lk888l/wheeled-legged_Robot-WL1/car_firmware/README_en.md

# WL1 Car Firmware

[中文](README.md) | [English](README_en.md) | [Back to project README](../README_en.md)

`car_firmware` is the vehicle-side firmware for the WL1 wheeled-legged robot. It
targets the STM32F411CEU6. The firmware reads the MPU6050 and the left and right
wheel encoders, runs cascaded PID control, drives two DC motors through a TB6612
and two leg servos, and receives remote commands over a Bluetooth UART, with optional nRF24L01+ support.

The current runtime path uses STM32 HAL, FreeRTOS, and C++23:

- `save` persists all motion tunings, the shared wheel-PWM dead zone, the angle Kp mode, and the adaptive leg-height switch to internal Flash; automatic Kp uses a tunable 61.5 mm reference with linear height compensation (see the [save protocol](docs/commands.md#flash-参数保存));
- A 10 ms attitude loop that calculates left and right wheel PWM;
- A 50 ms loop for speed, steering, roll, and leg-height control;
- ZX-D30 BLE UART at 9600 8N1 by default; nRF24L01+ is optional and disabled by default;
- USART1 DMA transmission and reception for online status monitoring and control-parameter updates;
- Runtime center-of-gravity pitch baseline tuning with `anglebias` over the car UART or
  BLE, with compensation based on the mean of both clamped leg targets
  (see the [command reference](docs/commands.md#控制命令));
- `rollbias` calibrates the roll midpoint used by adaptive leg height over the car UART/BLE
  or optional nRF commands; `save` retains the calibration across power cycles;
- Fixed-capacity ETL containers for command queues and UART buffers;
- Explicit, ordered hardware initialization calls in `main.cpp`, with a lightweight
  report that records every result without skipping later modules;
- A fail-safe gate that keeps wheel PWM at zero and does not create balancing
  tasks if required control hardware initialization fails, while preserving available
  command channels.

Further reading:

- [Software architecture](docs/architecture.md): startup flow, tasks, control loops, and concurrency model;
- [Command reference](docs/commands.md): serial/wireless commands, default parameters, and tuning sequence;
- [Debugging and troubleshooting](docs/troubleshooting.md): power-on checks, common faults, and CubeMX regeneration checks.

> [!WARNING]
> Balancing is enabled after the required control hardware and application
> tasks start successfully. This software gate does not replace physical safety:
> raise the wheels, disconnect motor power, or use a current-limited supply during
> initial flashing and tuning.

The car now provides PA0 onboard KEY click, double-click, and long-press events.
`ButtonTask` polls every 5 ms at priority 1 with a static 128-word stack and a bounded
event queue. All five application tasks derive from `AppTask`; the composition root
injects their dependencies. The existing 10/50 ms control periods and priorities remain.
Use the `button` command to inspect counts, dropped events, and the maximum sampling gap.
See [button integration](docs/button-a0.md) for timing semantics and validation (Chinese).

The Bluetooth build defaults to ZX-D30 on USART1 at 9600 8N1 and disables nRF initialization.
UART/radio availability and command-task creation do not gate balancing. Motion commands
expire after 500 ms: speed, turn and roll return to zero while balancing and leg-height
control continue. WeChat requires a BLE UART module; classic HC-05/JDY-31 SPP cannot
connect directly. See [Bluetooth UART setup and validation](docs/bluetooth-uart.md).

## Quick Start

### 1. Prepare the Tools

- CMake 3.28 or later;
- Ninja, Make, or another CMake-supported build tool;
- Arm GNU Toolchain with the `arm-none-eabi-` command prefix;
- OpenOCD and an ST-Link for flashing and debugging;
- STM32CubeMX (optional), required only when changing `.ioc` peripheral settings.

Verify that the tools are available in `PATH`:

```sh
cmake --version
arm-none-eabi-gcc --version
openocd --version
```

### 2. Build

Run the following commands in the `car_firmware` directory:

```sh
cmake -S . -B build/Debug -G Ninja -DCMAKE_BUILD_TYPE=Debug
cmake --build build/Debug --parallel
```

For an optimized build intended to run on the robot:

```sh
cmake -S . -B build/Release -G Ninja -DCMAKE_BUILD_TYPE=Release
cmake --build build/Release --parallel
```

Run the host regression tests for initialization, tasks, buttons, commands, and PID without a board:

```sh
cmake -S tests -B build/host-tests -G Ninja
cmake --build build/host-tests --parallel
ctest --test-dir build/host-tests --output-on-failure
```

If Ninja is unavailable, replace `-G Ninja` with an available generator, such as
`-G "MinGW Makefiles"` on Windows. Use a new build directory when changing
generators.

Build outputs are placed in the selected build directory:

- `WL1_F411CEU6_update.hex/.bin`: application update, preserving saved parameters;
- `WL1_F411CEU6_factory.hex/.bin`: first installation or factory reset, including a default parameter record;
- `WL1_F411CEU6.elf`: application debugging/flashing, without parameter records;
- `WL1_F411CEU6.hex/.bin`: compatibility names with the same contents as update;
- `WL1_F411CEU6.map`: linker map and memory analysis.

Build configurations:

| `CMAKE_BUILD_TYPE` | Compiler options | Purpose |
| --- | --- | --- |
| `Debug` or unspecified | `-Og -g` | Debugging, stepping, and variable inspection |
| `Release` | `-O3 -fno-fast-math` | Normal operation; preserves VQF NaN initialization semantics |
| `RelWithDebInfo` | `-O3 -fno-fast-math -g` | Optimized execution with debug information |
| `MinSizeRel` | `-Os` | Minimize image size |

The project always uses the Cortex-M4F hard-float ABI (`fpv4-sp-d16`), C11, and
C++23.

### 3. Flash with ST-Link

Connect SWDIO, SWCLK, GND, and the target-board reference voltage. For blank chips,
chips previously running other firmware, or a deliberate factory reset, run:

```sh
cmake --build build/Release --target flash_factory
# Later updates that retain saved tuning:
cmake --build build/Release --target flash_update
```

Factory erases sectors 0–7 and writes compiled defaults. Update erases only
sectors 0–6 and preserves the entire parameter sector 7. Both targets verify
the image and reset the device into normal operation.

If the controller supply has been independently verified while a particular
probe still reports a false low Vref, use the tested 100 kHz compatibility path:

```sh
openocd -f STlink_hla.cfg \
  -f build/Release/flash_factory.cfg
# For later updates use build/Release/flash_update.cfg.
```

Alternatively configure `WL1_OPENOCD_CONFIG` with the absolute path to
`STlink_hla.cfg` so the CMake flash targets use that probe backend.
Keep each generated flash script beside its matching HEX image.
An image does not encode erase policy: factory programming must erase all of
sector 7, including old records after the default record. See
[installation and parameter retention](docs/flash-images.md).

Full-image write and verification were tested at 1800 kHz; reset returns to the
100 kHz debugging speed. The deprecated HLA backend is only a compatibility
fallback for a confirmed measurement fault; use `STlink.cfg` for normal probes.

USART1 now prints one `[init][ OK ]` or `[init][FAIL]` line per module and ends
with an application summary. Only `state=ready control=on` means balancing and
motor output are allowed. A failed module is reported immediately, but the
remaining initialization steps still run.

## Startup Safety and PC13 Heartbeat

After the scheduler starts, `AppBootstrap` calls `CPP_Main()`. The entry point in
`Component/UserApp/main.cpp` explicitly initializes command UART, MPU6050, left
encoder, right encoder, wheel-motor PWM, left servo, and right servo in that
order. The optional nRF24L01+ is initialized last only when `WL1_ENABLE_NRF24=ON`
and is skipped by default. Each call records and logs its result, followed by a
3 ms delay; later modules are still attempted after a failure.

`InitializationReport::all_succeeded(bsp::kRequiredHardwareMask)` requires a valid
report and successful attempts for every required module. A missing required
module also fails this gate. A failed gate prevents `ServoControl` and
`MotionControl` from being created and forces safe
outputs. `Heartbeat` remains independent; `CommandService` remains available
when either USART1 or nRF initialized successfully.

PC13 is treated as active-low:

| State | LED pattern | Meaning |
| --- | --- | --- |
| `booting` | 100 ms on / 100 ms off | Initialization in progress |
| `ready` | 80 ms on / 920 ms off | Control enabled |
| `init-failed` | Two short flashes, then pause | Hardware failure; safe mode |
| `task-failed` | Three short flashes, then pause | Application task creation failed |
| `runtime-fault` | 80 ms on / 80 ms off | Runtime IMU failure; outputs stopped |

Without a serial adapter, inspect `g_app_system_state`,
`g_app_hardware_attempted_mask`, `g_app_hardware_failed_mask`, `g_app_task_failed_mask`, and
`g_app_control_enabled` through ST-Link/GDB.

## First Power-On

Use the following sequence to narrow down faults safely:

1. Disconnect motor power or raise the wheels off the ground, and power only the logic circuitry and ST-Link;
2. Confirm that USART1 receives the startup log;
3. Run `showimu -y` and verify that the attitude values remain stable while the robot is stationary;
4. Run `showrpm -y`, turn each wheel by hand, and confirm that both encoders respond;
5. Power the servos and use `legheight 44.5` to check the direction and mechanical limits on both sides;
6. Connect the Bluetooth client, send a motion command with zero velocity, steering, and roll, then use `controlstate` to check the targets;
7. Finally, connect motor power and check the feedback direction using a current-limited power supply and a stand.

For detailed checks, see [Debugging and troubleshooting](docs/troubleshooting.md).

## Hardware Connections

See the [hardware files on the project homepage](../README_en.md#hardware-files)
for the PCB fabrication archive and schematic PDF.

### Core and Debug Interfaces

| Function | MCU pin | Parameters |
| --- | --- | --- |
| USART1 TX | PA15 | 9600 (configurable), 8-N-1, DMA2 Stream 7 |
| USART1 RX | PA10 | 9600 (configurable), 8-N-1, DMA2 Stream 5, receive-to-idle |
| SWDIO | PA13 | ST-Link |
| SWCLK | PA14 | ST-Link |
| Status LED | PC13 | Active-low; state-dependent heartbeat above |
| HSE | PH0/PH1 | 25 MHz |
| LSE | PC14/PC15 | 32.768 kHz |

PA15 is not the usual default USART1_TX pin. When connecting a serial adapter,
follow this table and `Core/Src/usart.c`.

### MPU6050

| Signal | MCU pin | Parameters |
| --- | --- | --- |
| SCL | PB6 | I2C1, 400 kHz |
| SDA | PB7 | I2C1, 400 kHz |
| Address | — | 7-bit `0x68` (the driver uses the left-shifted value `0xD0`) |

The current configuration uses a ±1000 °/s gyroscope range, a ±4 g accelerometer
range, and VQF for attitude fusion. DLPF=0 and SMPLRT_DIV=9 retain 800 Hz sensor
register updates; the host reads and advances VQF at 100 Hz (10 ms).
Ordinary `control off` keeps the estimator running with actuators disabled.
`control on` retains the learned bias and still requires the 500 ms startup gate.
Installation and exclusive maintenance can still pause sampling.

### Motors and Encoders

| Function | MCU pin | Peripheral |
| --- | --- | --- |
| Left-wheel PWM / TB6612 A | PA8 | TIM1_CH1, approximately 10 kHz |
| Right-wheel PWM / TB6612 B | PA9 | TIM1_CH2, approximately 10 kHz |
| AIN1 / AIN2 | PA6 / PA7 | Left-wheel direction |
| BIN1 / BIN2 | PB0 / PB1 | Right-wheel direction |
| Left encoder A / B | PA5 / PA1 | TIM2_CH1 / CH2 |
| Right encoder A / B | PB4 / PB5 | TIM3_CH1 / CH2 |

The current PID path inverts the TB6612 B-channel direction. Both PWM channels
share a runtime-adjustable minimum nonzero compare value. It defaults to zero, so
compensation is disabled until set with `deadzone <0..1000>` and persisted with `save`.
The final PWM command is limited to `-1000..1000`. A zero command uses a dedicated
safe branch, so the dead zone is not reapplied and the compare value remains zero.

### Leg Servos

| Function | MCU pin | Peripheral |
| --- | --- | --- |
| Left-leg servo | PA2 | TIM9_CH1 |
| Right-leg servo | PA3 | TIM9_CH2 |

TIM9 generates 100 Hz PWM. The software limits the target leg height to
`44.5..78.5 mm` and converts it to a servo angle using four-bar inverse
kinematics. Mechanical dimensions and coordinate-system definitions are in
`Component/UserApp/CtrlAlgorithm/LegKinematics.hpp`.

### nRF24L01+ (Optional, Disabled by Default)

This channel is enabled only when building with `-DWL1_ENABLE_NRF24=ON`.

| nRF signal | MCU pin | Description |
| --- | --- | --- |
| SCK | PB13 | SPI2_SCK |
| MISO | PB14 | SPI2_MISO |
| MOSI | PB15 | SPI2_MOSI |
| CSN | PA4 | Software-controlled chip select, active low |
| CE | PB12 | TX/RX mode control |
| IRQ | PA12 | Pull-up input, falling-edge EXTI; no floating pin when absent |
| VCC | 3.3 V | Do not connect to 5 V |
| GND | GND | Common ground with the MCU |

The SPI2 clock is approximately 6.25 Mbit/s, and both transmission and reception
use DMA. Place a decoupling capacitor near the nRF module's power pins. If the
wireless link behaves abnormally, first check the 3.3 V supply and common ground.

### Reserved OLED Interface

The driver in `Component/HardWare/OLED` is compiled, but the current application
does not initialize or refresh the OLED. CubeMX reserves these software-I²C pins:

| Signal | MCU pin |
| --- | --- |
| O_SCL | PB10 |
| O_SDA | PB3 |

## Remote-Control Command Protocol

Text commands are sent over the USART1 Bluetooth UART by default. Clients
should use `@<command>\n` framing, where `\n` represents an actual LF byte.
The motion-command body has the following format:

```text
R <turn_target> <velocity_target> <roll_degrees> <leg_height_mm>
```

Example:

```text
@R 0 0 0 61.5\n
```

The field order must remain steering, velocity, roll, and leg height. The
client's direction conventions must match the car's control coordinate system.
Command bodies are limited to 32 bytes, with support for BLE fragmentation.
See the [ZX-D30 Bluetooth documentation](docs/zx-d30.md) for wiring and BLE
configuration and the [command reference](docs/commands.md) for framing rules
and command limits.

### Optional nRF24L01+ Channel

When enabled, the car enters nRF receive mode only after initialization and
register readback verification succeed. A valid payload uses the same command
body, padded to 32 bytes with `0x00`. The RF settings are:

| Parameter | Current setting |
| --- | --- |
| Data rate | 2 Mbps |
| RF channel | 2 (2402 MHz) |
| Address width | 5 bytes |
| RX Pipe 0 / TX address | `11 52 01 31 41` |
| Payload width | 32 bytes |
| RF power | 0 dBm |
| CRC | 1 byte |
| Auto ACK | Enabled |
| Auto retry | 500 μs interval, up to 15 retries |

When using this channel, the sender's RF settings and `R` command format must
match the car. For all available commands and their limits, see the
[command reference](docs/commands.md).

## Software Structure

```text
car_firmware/
├── Component/
│   ├── Application/               # Initialization report, AppTask, runtime status
│   ├── Bsp/                       # Board facade, stable module IDs and names
│   ├── HardWare/
│   │   ├── IMU/                  # MPU6050 and VQF
│   │   ├── Motor/                # Encoders, TB6612, and servos
│   │   ├── OLED/                 # OLED driver, currently unused
│   │   └── Telecontrol/          # nRF24L01+ driver
│   ├── Module/
│   │   ├── Basic/                # TaskReactor and SafeQueue
│   │   └── include/etl/          # Embedded Template Library
│   ├── Peripheral/               # USART DMA wrapper
│   └── UserApp/
│       ├── CtrlAlgorithm/        # PID, LQR, and leg kinematics
│       ├── Tasks/                # Five AppTask-derived business tasks
│       ├── ControlState.hpp      # Coherent parameter and feedback snapshots
│       └── main.cpp              # Composition, initialization, and safety gates
├── Core/                         # STM32CubeMX-generated code
├── Drivers/                      # STM32 HAL / CMSIS
├── Middlewares/                  # FreeRTOS
├── CMakeLists.txt
├── CMakeLists_template.txt
├── STlink.cfg
├── STlink_hla.cfg                 # Low-speed fallback for confirmed false Vref
├── tests/                          # Host startup-semantics tests
└── WL1_F411CEU6.ioc
```

The C entry point is `Core/Src/main.c`. `MX_FREERTOS_Init()` creates only the
`AppBootstrap` task. After the scheduler starts, that task calls `CPP_Main()` to
construct board services, initialize every hardware step, and create eligible
application tasks, then deletes itself.

The structure draws on the composition entry point, module encapsulation, and
layering in [esp_idf_template](https://github.com/lk888l/esp32_idf/tree/main/esp_idf_template).
WL1 uses explicit per-module initialization calls in `main.cpp`, followed by a
single safety gate, and keeps available diagnostics after a failure. Hardware
initialization has no factory, function-pointer table, or observer callback.
Independent FreeRTOS task classes retain their constructor-injected dependencies
and static object lifetimes. See the [architecture guide](docs/architecture.md)
for the adaptation choices and steps for adding modules.

`MotionControlTask` runs the existing cascaded PID algorithm and is started only
after the safety gate passes. The LQR path remains available for experiments but
does not currently run. `MainControl.*` and OLED remain outside the runtime path.

## Development Guidelines

- Keep handwritten logic in `USER CODE` sections and synchronize generated GPIO changes with the `.ioc` file;
- `CMakeLists.txt` is marked as a template-generated file, so persistent changes should also be applied to `CMakeLists_template.txt`;
- Source globs use `CONFIGURE_DEPENDS` to discover new application task files;
- Derive business tasks from `AppTask`, inject dependencies, and exchange control data through `ControlState` snapshots;
- Assign new hardware a stable ID in `Bsp/HardwareModule.hpp`, then explicitly initialize it and record the result in `main.cpp`;
- Do not call regular FreeRTOS APIs from an ISR; use only the `...FromISR` variants;
- Interrupts that call FreeRTOS ISR APIs must have an NVIC numerical priority of 5 or greater;
- Avoid dynamic allocation, blocking I/O, and high-frequency UART output in control tasks;
- After changing wheel direction, encoder direction, or attitude signs, raise the wheels off the ground and verify the closed-loop feedback direction;
- When changing the remote-control command protocol, check the Bluetooth client, car firmware, and command documentation together;
- Before committing, complete at least Debug and Release builds and run `git diff --check`.
