lk888l/wheeled-legged_Robot-WL1/car_firmware/CMakeLists_template.txt

#${templateWarning}
set(CMAKE_SYSTEM_NAME Generic)
set(CMAKE_SYSTEM_VERSION 1)
${cmakeRequiredVersion}
# specify cross-compilers and tools
set(CMAKE_C_COMPILER arm-none-eabi-gcc)
set(CMAKE_CXX_COMPILER arm-none-eabi-g++)
set(CMAKE_ASM_COMPILER  arm-none-eabi-gcc)
set(CMAKE_AR arm-none-eabi-ar)
set(CMAKE_OBJCOPY arm-none-eabi-objcopy)
set(CMAKE_OBJDUMP arm-none-eabi-objdump)
set(SIZE arm-none-eabi-size)
set(CMAKE_TRY_COMPILE_TARGET_TYPE STATIC_LIBRARY)

# project settings
project(${projectName} C CXX ASM)
set(CMAKE_CXX_STANDARD 23)
set(CMAKE_C_STANDARD 11)

set(WL1_COMMAND_UART_BAUD "9600" CACHE STRING "Bluetooth/command UART baud rate")
if(NOT WL1_COMMAND_UART_BAUD MATCHES "^(9600|19200|38400|57600|115200|128000)$")
    message(FATAL_ERROR "Unsupported WL1_COMMAND_UART_BAUD")
endif()
option(WL1_ENABLE_NRF24 "Enable the optional SPI radio remote" OFF)
add_compile_definitions(WL1_COMMAND_UART_BAUD=${WL1_COMMAND_UART_BAUD}
    WL1_ENABLE_NRF24=$<BOOL:${WL1_ENABLE_NRF24}>)

#Uncomment for hardware floating point
add_compile_definitions(ARM_MATH_CM4;ARM_MATH_MATRIX_CHECK;ARM_MATH_ROUNDING)
add_compile_options(-mfloat-abi=hard -mfpu=fpv4-sp-d16)
add_link_options(-mfloat-abi=hard -mfpu=fpv4-sp-d16)

#Uncomment for software floating point
#add_compile_options(-mfloat-abi=soft)

add_compile_options(-mcpu=${mcpu} -mthumb -mthumb-interwork)
add_compile_options(-ffunction-sections -fdata-sections -fno-common -fmessage-length=0)

# uncomment to mitigate c++17 absolute addresses warnings
#set(CMAKE_CXX_FLAGS "$${CMAKE_CXX_FLAGS} -Wno-register")

# Enable assembler files preprocessing
add_compile_options($<$<COMPILE_LANGUAGE:ASM>:-x$<SEMICOLON>assembler-with-cpp>)

if ("$${CMAKE_BUILD_TYPE}" STREQUAL "Release")
    message(STATUS "Maximum optimization for speed")
    # VQF uses NaN filter-state sentinels; fast-math breaks its initialization.
    add_compile_options(-O3 -fno-fast-math)
elseif ("$${CMAKE_BUILD_TYPE}" STREQUAL "RelWithDebInfo")
    message(STATUS "Maximum optimization for speed, debug info included")
    add_compile_options(-O3 -fno-fast-math -g)
elseif ("$${CMAKE_BUILD_TYPE}" STREQUAL "MinSizeRel")
    message(STATUS "Maximum optimization for size")
    add_compile_options(-Os)
else ()
    message(STATUS "Minimal optimization, debug info included")
    add_compile_options(-Og -g)
endif ()

include_directories(${includes}
                    Component/Application Component/Bsp Component/UserApp Component/HardWare/OLED Component/HardWare/Motor Component/HardWare/IMU Component/Peripheral Component/Module/include
                    Component/Module/Basic Component/HardWare/Telecontrol
)

add_definitions(${defines})

file(GLOB_RECURSE SOURCES CONFIGURE_DEPENDS ${sources}
    "Component/Application/*.*" "Component/Bsp/*.*" "Component/UserApp/*.*" "Component/HardWare/OLED/*.*" "Component/HardWare/Motor/*.*" "Component/HardWare/IMU/*.*" "Component/HardWare/Telecontrol/*.*"
    "Component/Peripheral/*.*" "Component/Module/include/etl/*.*" "Component/Module/Basic/*.*"
    )

set(LINKER_SCRIPT $${CMAKE_SOURCE_DIR}/${linkerScript})

add_link_options(-Wl,-gc-sections,--print-memory-usage,-Map=$${PROJECT_BINARY_DIR}/$${PROJECT_NAME}.map)
add_link_options(-mcpu=${mcpu} -mthumb -mthumb-interwork)
add_link_options(-T $${LINKER_SCRIPT})

add_executable($${PROJECT_NAME}.elf $${SOURCES} $${LINKER_SCRIPT})

include(cmake/FirmwareImages.cmake)
