lk888l/wheeled-legged_Robot-WL1/hardware/BOM.xlsx

结构 |  | PCB
名称 | 数量 | 名称 | 数量
10*15*4轴承 | 2 | PCB主板 | 1
6*11*4轴承 | 4 | STM32F411CEU6最小系统 | 1
MG996R舵机180度 | 2 | MPU6050模块 | 1
12V600转/分钟 | 2 | TB6612模块 | 1
3000mah 12V锂电池+充电器 | 1 | 3V3降压模块 | 1
M3螺丝12mm | 4 | 5V降压模块 | 1
M4螺丝12mm | 8 | 蓝牙串口模块（ZX-D30） | 1
M2螺丝8mm | 2 | 1*20排母 | 2
M3螺丝5mm | 2 | ZH1.25*6直插座 | 2
50mm宽魔术贴 | 50mm | 1*3排针 | 1
 |  | 1*8排母 | 3
 |  | 1*4排母 | 3
 |  | zh1.5*6电机线(0.2m) | 2
 |  | 船型开关(10*15) | 1
 |  | DC母座(5.5*2.1) | 1
