lk888l/wheeled-legged_Robot-WL1/hardware/wheeled-legged_Robot-WL1-schematics.pdf

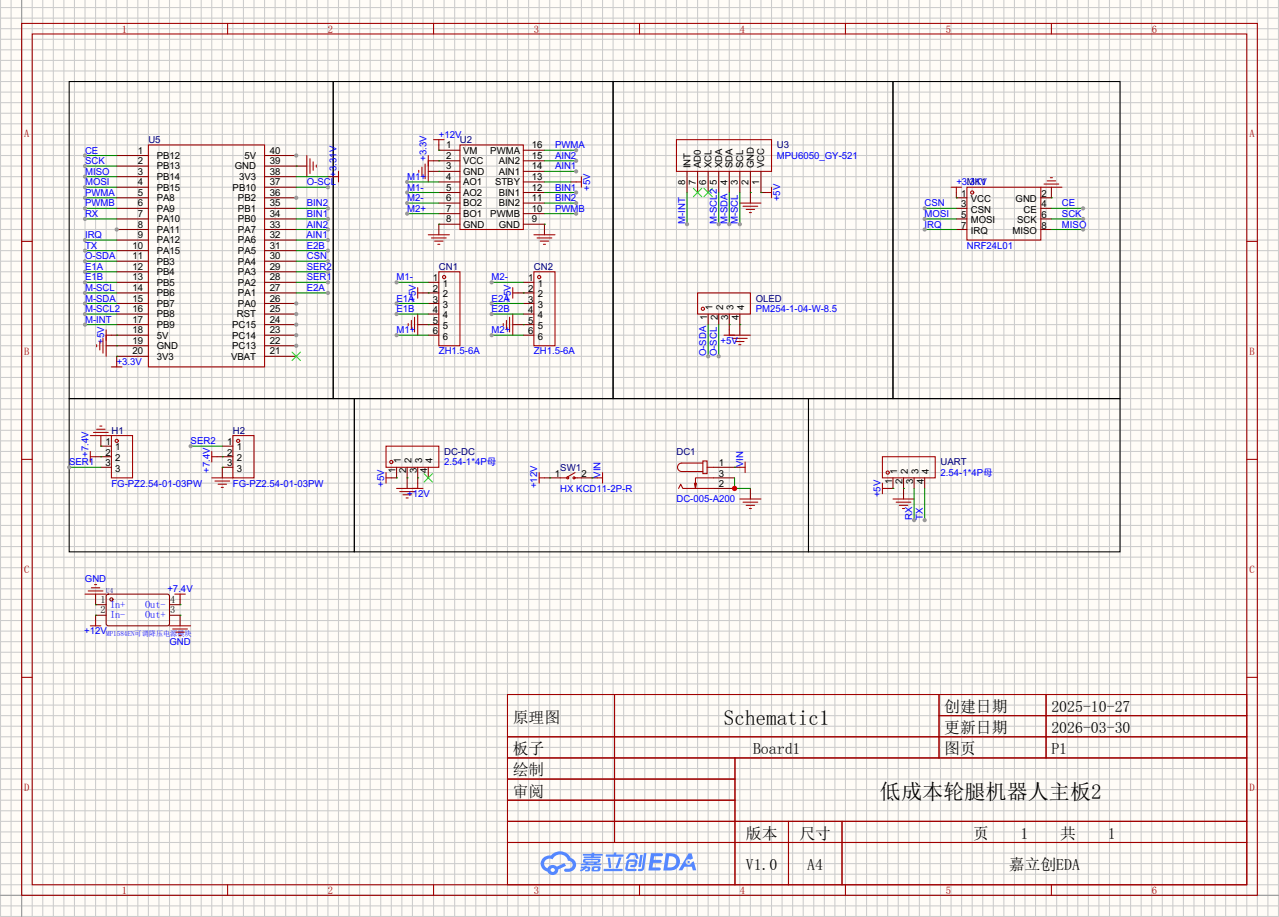
[picture p4: page 1]

SCK | | | PB13 2 | 3V3 | 38 GND 39 5V 40 | | | | | | | PWMB | | 10 BIN2 11 BIN1 12 STBY 13 AIN1 14 AIN2 15 PWMA 16 U2 | | AIN1
CE | | | PB12 1 | | | | | | | | VCC 2 | | | | | AIN2 | | | MPU6050_GY-521
MISO | | | PB14 3 | | | | | | | | GND 3
MOSI | | | PB15 4 | | | O-SCL | | M1- | | | AO1 4 AO2 5 | | | | | BIN1 | | | | | +3.31V | MK1
PWMA | | | PA8 5 | | | | | M2- | | | BO2 6 | | | | | BIN2 | | | | | | | VCC 1 | GND | | 2
PWMB | | | PA9 6 | | | BIN2 | | M2+ | | | BO1 7 | | | | | PWMB | | | | CSN | | | CSN 3 | | CE | 4 | CE
RX | | | PA10 7 | | | BIN1 | | | | | | | | | | | | | | MOSI | | | | SCK | | 6 MOSI 5 | SCK

U5 | | | | | | | | | VM 1 | | | | | PWMA | | | U3

PA11 8 | PA0 | 26 PA1 27 PA2 28 PA3 29 PA4 30 PA5 31 PA6 32 PA7 33 PB0 34 PB1 35 PB2 36 PB10 37 | AIN2 | | | | | GND 8 | | GND | 9 | | | | | | IRQ | | | IRQ 7 | MISO | | 8 | MISO

IRQ | | | PA12 9 | | | AIN1
TX | | | PA15 10 | | | E2B | | | | | | | | | | | | | | | | NRF24L01
O-SDA | | | PB3 11 | | | CSN
E1A | | | PB4 12 | | | SER2 | | | CN1 | | | | | CN2
E1B | | | PB5 13 | | | SER1 | M1- | | 1 | 1 | | M2- | | 1 | 1
M-SCL | | | PB6 14 | | | E2A | | | 2 | 2 | | | | 2 | 2
M-SDA | | | PB7 15 | | | | E1A | | 3 | 3 | | E2A | | 3 | 3 | | | OLED
M-SCL2 | | | PB8 16 | | | | E1B | | 4 | 4 | | E2B | | 4 | 4 | | | PM254-1-04-W-8.5

M-INT | | | 3V3 20 PB9 17 | VBAT | 21 PC13 22 PC14 23 PC15 24 RST 25 | | | | 5 | 5 | | | | 5 | 5

5V 18 | | | | M1+ | | 6 | 6 | | M2+ | | 6 | 6
GND 19 | | | | | | | | | | | | | | +5V

H1 | | H2
1 | | | SER2 | 1
2 | 1 | 1 | DC-DC | DC1
3 | | | 3 | | | 1 | SW1 | 2 | | | 2.54-1*4P母
FG-PZ2.54-01-03PW | | | | FG-PZ2.54-01-03PW | | | | | | | 2

SER1 | | 3 | 2 | | | 2 | | 2.54-1*4P母 | | | | | 1 | UART

HX KCD11-2P-R

GND

更新日期 | 2026-03-30

板子 | Board1 | | 图页 | P1
绘制

D | 审阅 | | 低成本轮腿机器人主板2 | | | D
