lk888l/wheeled-legged_Robot-WL1/car_firmware/Core/Inc/main.h

#define KEY_A0_Pin GPIO_PIN_0
#define KEY_A0_GPIO_Port GPIOA
#define SPI2_CS_Pin GPIO_PIN_4
#define SPI2_CS_GPIO_Port GPIOA
#define AIN1_Pin GPIO_PIN_6
#define AIN1_GPIO_Port GPIOA
#define AIN2_Pin GPIO_PIN_7
#define AIN2_GPIO_Port GPIOA
#define BIN1_Pin GPIO_PIN_0
#define BIN1_GPIO_Port GPIOB
#define BIN2_Pin GPIO_PIN_1
#define BIN2_GPIO_Port GPIOB
#define O_SCL_Pin GPIO_PIN_10
#define O_SCL_GPIO_Port GPIOB
#define CE_Pin GPIO_PIN_12
#define CE_GPIO_Port GPIOB
#define SPI2_IRQ_Pin GPIO_PIN_12
#define SPI2_IRQ_GPIO_Port GPIOA
#define SPI2_IRQ_EXTI_IRQn EXTI15_10_IRQn
#define O_SDA_Pin GPIO_PIN_3
#define O_SDA_GPIO_Port GPIOB
