lk888l/wheeled-legged_Robot-WL1/car_firmware/Component/HardWare/Motor/Servo.cpp

/********************************************************************************
  * @file           : Servo.cpp
  * @author         : Luka
  * @brief          : None
  * @attention      : None
  * @date           : 26-3-25
  *******************************************************************************/


#include "Servo.hpp"

// 定时器回调函数（静态 C 风格函数，转发给类成员）
void ServoTimerCallback(TimerHandle_t xTimer) {
    Servo* s = (Servo*)pvTimerGetTimerID(xTimer);
    s->updateSmoothing();
}

Servo::Servo(TIM_HandleTypeDef *htim, uint32_t channel, int32_t minPulseUs, int32_t maxPulseUs, float maxAngle, float angle)
        : HTim(htim), TimChannel(channel)
        , MinPulse(minPulseUs), MaxPulse(maxPulseUs), MaxAngle(maxAngle)
{
    // 创建软件定时器，周期为 20ms
    xTimer = xTimerCreate("ServoTimer", pdMS_TO_TICKS(UPDATE_PERIOD_MS),
                      pdTRUE, (void*)this, ServoTimerCallback);
    K_Pulse = (float)(maxPulseUs - minPulseUs) / maxAngle;
    B_Pulse = (float)minPulseUs;
    CurrentAngle = TargetAngle = angle;
    setPWM_FromAngle(angle);

}

void Servo::setPWM_FromAngle(float angle) {
    if (angle < 0) angle = 0;
    else if (angle > MaxAngle) angle = MaxAngle;
    // 映射：角度 -> 脉冲宽度
    // 公式：脉宽 = 最小脉宽 + (当前角度 / 最大角度) * (最大脉宽 - 最小脉宽)
//    uint32_t pulse = MinPulse + (uint32_t)((angle / MaxAngle) * (MaxPulse - MinPulse));
    uint32_t pulse = (uint32_t)(angle * K_Pulse + B_Pulse);
    __HAL_TIM_SET_COMPARE(HTim, TimChannel, pulse);
}


bool Servo::Init() {
    if (HTim == nullptr || xTimer == nullptr) {
        return false;
    }
    taskENTER_CRITICAL();
    OutputEnabled = HAL_TIM_PWM_Start(HTim, TimChannel) == HAL_OK;
    taskEXIT_CRITICAL();
    return OutputEnabled;
}

void Servo::stop() {
    taskENTER_CRITICAL();
    OutputEnabled = false;
    if (xTimer != nullptr) {
        xTimerStop(xTimer, 0);
    }
    if (HTim != nullptr) {
        __HAL_TIM_SET_COMPARE(HTim, TimChannel, 0);
        HAL_TIM_PWM_Stop(HTim, TimChannel);
    }
    taskEXIT_CRITICAL();
}

bool Servo::setAngle_Immediate(float angle) {
    taskENTER_CRITICAL();
    if(Limit_Max_Angle!=0 && angle>Limit_Max_Angle)   angle = Limit_Max_Angle;
    else if(angle<Limit_Min_Angle)  angle = Limit_Min_Angle;
    if (xTimer != nullptr) {
        xTimerStop(xTimer, 0);      //stop soft timer to immediate execution
    }
    setPWM_FromAngle(angle);
    CurrentAngle = TargetAngle = angle;
    OutputEnabled = HAL_TIM_PWM_Start(HTim, TimChannel) == HAL_OK;
    taskEXIT_CRITICAL();
    return OutputEnabled;
}

void Servo::setAngle_Smooth(float targetAngle, float speed) {
    taskENTER_CRITICAL();
    if(Limit_Max_Angle!=0 && targetAngle>Limit_Max_Angle)   targetAngle = Limit_Max_Angle;
    else if(targetAngle<Limit_Min_Angle)  targetAngle = Limit_Min_Angle;
    if(speed == 0){
        setAngle_Immediate(targetAngle);
        taskEXIT_CRITICAL();
        return;
    }
    TargetAngle = targetAngle;
    StepSize = speed * (UPDATE_PERIOD_MS / 1000.0f);
    // stop() disables CCxE. Restart it when explicitly commanded again.
    if (!OutputEnabled) {
        setPWM_FromAngle(CurrentAngle);
        OutputEnabled = HAL_TIM_PWM_Start(HTim, TimChannel) == HAL_OK;
    }
    if (xTimer != nullptr) {
        xTimerStart(xTimer, 0); // start soft timer
    } else {
        setAngle_Immediate(targetAngle);
    }
    taskEXIT_CRITICAL();
}

float Servo::getCurrentAngle() const {
    return CurrentAngle;
}

void Servo::updateSmoothing() {
    taskENTER_CRITICAL();
    // A queued timer callback must not restore compare after a safety stop.
    if (!OutputEnabled) { taskEXIT_CRITICAL(); return; }
    float diff = TargetAngle - CurrentAngle;
    if (this->abs(diff) <= StepSize) {
        CurrentAngle = TargetAngle;
        xTimerStop(xTimer, 0); // 到达目的地，停掉定时器节省资源
    }
    else {
        // 向目标方向迈进一步
        if (diff > 0) CurrentAngle += StepSize;
        else CurrentAngle -= StepSize;
    }
    setPWM_FromAngle(CurrentAngle);
    taskEXIT_CRITICAL();
}

int32_t Servo::PhysicalToPulse(float physicalAngle, float baseMinPulse, float baseMaxPulse, float baseMaxAngle) {
    return (int32_t)(baseMinPulse + (physicalAngle / baseMaxAngle) * (baseMaxPulse - baseMinPulse));
}
