lk888l/wheeled-legged_Robot-WL1/car_firmware/Component/UserApp/MotionParameterJournal.hpp

#pragma once

#include "MotionParameters.hpp"
#include <algorithm>

namespace MotionSettings {

enum class SaveResult { saved, unchanged, full, invalid, io_error, busy };

// A record becomes valid only after its final commit word has been programmed.
// Never reuse a partially programmed slot. Normal saves never erase old records.
template<class Flash>
class ParameterJournal {
public:
    static constexpr std::uint32_t magic = 0x574C3150U; // WL1P
    // Keep the 84-byte stride so existing version-1 records remain readable.
    // Version 2 uses bit 16 of the field-count word for fixed/manual angle Kp.
    // Version 3 stores the shared motor dead zone in the high half of the
    // version word. Version 4 adds the auto-leg switch in bit 17 of the
    // field-count word. Version 5 replaces the unused sequence word with the
    // roll calibration float. Recency is always the physical append order.
    // All versions retain the original 15-float payload and 84-byte stride.
    static constexpr std::uint32_t version = 5;
    static constexpr std::uint32_t version_mask = 0xFFFFU;
    static constexpr unsigned deadzone_shift = 16U;
    static constexpr std::uint32_t manual_kp_flag = 1U << 16;
    static constexpr std::uint32_t auto_leg_disabled_flag = 1U << 17;
    static constexpr std::uint32_t committed = 0x434F4D54U;
    static constexpr std::size_t header_words = 4;
    static constexpr std::size_t crc_index = header_words + parameter_count;
    static constexpr std::size_t commit_index = crc_index + 1;
    using Record = std::array<std::uint32_t, commit_index + 1>;
    static constexpr std::size_t record_bytes = sizeof(Record);

    explicit ParameterJournal(Flash& flash) : flash_(flash) {}

    bool load(Parameters& parameters)
    {
        const auto state = scan();
        if (state.latest == no_slot) return false;
        parameters = parametersFrom(state.record);
        return true;
    }

    SaveResult save(const Parameters& parameters, bool recycle = false)
    {
        if (!valid(parameters)) return SaveResult::invalid;
        const auto state = scan();
        if (state.latest != no_slot && sameParameters(parametersFrom(state.record), parameters))
            return SaveResult::unchanged;
        auto slot = state.next;
        if (slot >= slotCount()) {
            if (!recycle) return SaveResult::full;
            // Explicit maintenance operation only: a power loss during recycling
            // can leave no valid record. Boot then keeps compiled defaults.
            if (!flash_.erase()) return SaveResult::io_error;
            slot = 0;
        }
        const auto record = makeRecord(parameters);
        const auto offset = slot * record_bytes;
        for (std::size_t i = 0; i < commit_index; ++i) {
            if (!flash_.programWord(offset + i * 4, record[i])) return SaveResult::io_error;
            flash_.yieldAfterProgram();
        }
        // Verify all data before publishing the commit marker.
        auto readback = read(slot);
        if (!std::equal(record.begin(), record.begin() + commit_index, readback.begin()))
            return SaveResult::io_error;
        if (!flash_.programWord(offset + commit_index * 4, committed)) return SaveResult::io_error;
        flash_.yieldAfterProgram();
        readback = read(slot);
        return readback == record && validRecord(readback) ? SaveResult::saved : SaveResult::io_error;
    }

    // Shared by runtime saves and the factory image's compile-time default record.
    static constexpr Record makeRecord(const Parameters& parameters) noexcept
    {
        Record record{};
        record[0] = magic;
        record[1] = version | (std::uint32_t{parameters.motor_deadzone} << deadzone_shift);
        record[2] = parameter_count | (parameters.angle_kp_auto ? 0U : manual_kp_flag) |
            (parameters.auto_leg_enabled ? 0U : auto_leg_disabled_flag);
        record[3] = std::bit_cast<std::uint32_t>(parameters.roll_bias);
        const auto words = encode(parameters);
        std::copy(words.begin(), words.end(), record.begin() + header_words);
        record[crc_index] = crc(record);
        record[commit_index] = committed;
        return record;
    }

    static constexpr std::uint32_t crc(const Record& record) noexcept
    {
        // CRC-32/ISO-HDLC, explicitly little-endian words on host and target.
        std::uint32_t result = 0xFFFFFFFFU;
        for (std::size_t i = 0; i < crc_index; ++i) {
            for (unsigned byte = 0; byte < 4; ++byte) {
                result ^= (record[i] >> (byte * 8)) & 0xFFU;
                for (unsigned bit = 0; bit < 8; ++bit)
                    result = (result >> 1) ^ ((result & 1U) ? 0xEDB88320U : 0U);
            }
        }
        return ~result;
    }

private:
    static constexpr std::size_t no_slot = static_cast<std::size_t>(-1);
    struct Scan {
        std::size_t latest = no_slot;
        std::size_t next = 0;
        Record record{};
    };
    Flash& flash_;

    std::size_t slotCount() const { return flash_.capacity_bytes / record_bytes; }

    Record read(std::size_t slot)
    {
        Record record{};
        for (std::size_t i = 0; i < record.size(); ++i)
            record[i] = flash_.readWord(slot * record_bytes + i * 4);
        return record;
    }

    static Parameters parametersFrom(const Record& record)
    {
        ParameterWords words{};
        std::copy_n(record.begin() + header_words, parameter_count, words.begin());
        auto parameters = decode(words);
        const auto schema = record[1] & version_mask;
        parameters.angle_kp_auto = schema == 1U || (record[2] & manual_kp_flag) == 0U;
        if (schema >= 3U && schema <= version) {
            parameters.motor_deadzone = static_cast<std::uint16_t>(record[1] >> deadzone_shift);
        }
        if (schema >= 4U && schema <= version) {
            parameters.auto_leg_enabled = (record[2] & auto_leg_disabled_flag) == 0U;
        }
        if (schema == version) {
            parameters.roll_bias = std::bit_cast<float>(record[3]);
        }
        return parameters;
    }

    static bool validRecord(const Record& record)
    {
        const auto schema = record[1] & version_mask;
        const bool supported = (record[1] == 1U && record[2] == parameter_count) ||
            (record[1] == 2U && (record[2] & ~manual_kp_flag) == parameter_count) ||
            (schema == 3U && (record[2] & ~manual_kp_flag) == parameter_count) ||
            ((schema == 4U || schema == version) &&
             (record[2] & ~(manual_kp_flag | auto_leg_disabled_flag)) == parameter_count);
        return record[0] == magic && supported &&
            record[commit_index] == committed && record[crc_index] == crc(record) &&
            valid(parametersFrom(record));
    }

    Scan scan()
    {
        Scan state;
        for (std::size_t slot = 0; slot < slotCount(); ++slot) {
            const auto record = read(slot);
            if (!std::all_of(record.begin(), record.end(), [](auto word) { return word == 0xFFFFFFFFU; }))
                state.next = slot + 1;
            if (validRecord(record)) {
                state.latest = slot;
                state.record = record;
            }
        }
        return state;
    }
};

} // namespace MotionSettings
