lk888l/wheeled-legged_Robot-WL1/car_firmware/Component/UserApp/MainControl.cpp

/********************************************************************************
  * @file           : MainControl.cpp
  * @author         : Luka
  * @brief          : None
  * @attention      : None
  * @date           : 26-3-7
  *******************************************************************************/


#include "MainControl.hpp"
