lk888l/wheeled-legged_Robot-WL1/car_firmware/Component/UserApp/MainControl.hpp

/********************************************************************************
  * @file           : MainControl.hpp
  * @author         : Luka
  * @brief          : None
  * @attention      : None
  * @date           : 26-3-7
  *******************************************************************************/


#ifndef WL1_F411CEU6_MAINCONTROL_HPP
#define WL1_F411CEU6_MAINCONTROL_HPP


class MainControl {

};


#endif //WL1_F411CEU6_MAINCONTROL_HPP
