lk888l/wheeled-legged_Robot-WL1/car_firmware/Component/UserApp/ControlState.hpp

#pragma once

#include <array>
#include <cstdint>
#include "CtrlAlgorithm/BalanceCompensation.hpp"
#include "MotionParameters.hpp"
#include "MotionStorageInterlock.hpp"

namespace app {

using PidGains = MotionSettings::PidGains;

struct ControlParameters {
    PidGains angle{MotionSettings::Parameters{}.angle};
    PidGains velocity{MotionSettings::Parameters{}.velocity};
    PidGains difference{MotionSettings::Parameters{}.difference};
    PidGains roll{MotionSettings::Parameters{}.roll};
    // Runtime calibration at minimum leg height; the height correction is separate.
    float angle_bias{MotionSettings::Parameters{}.minimum_pitch_bias};
    // Corrected roll = raw IMU roll + this calibration, independent of remote targets.
    float roll_bias{MotionSettings::Parameters{}.roll_bias};
    float velocity_target{0.0F};
    float difference_target{0.0F};
    float leg_height{MotionSettings::Parameters{}.leg_height};
    float roll_target{MotionSettings::Parameters{}.roll_target};
    bool show_imu{false};
    bool show_rpm{false};
    // -p tunes the 61.5 mm reference gain; -manual explicitly selects fixed Kp.
    bool angle_kp_auto{MotionSettings::Parameters{}.angle_kp_auto};
    // Minimum nonzero compare value, shared by the left/A and right/B wheel outputs.
    std::uint16_t motor_deadzone{MotionSettings::default_motor_deadzone};
    // Only accepted movement commands renew this deadline; PID tuning does not.
    uint32_t motion_command_tick{};
    bool motion_command_received{};
    bool auto_leg_enabled{MotionSettings::Parameters{}.auto_leg_enabled};
};

struct LegTargets { float left{44.5F}; float right{44.5F}; };

struct ControlFeedback {
    std::array<float, 3U> euler{};
    float angle_kp{70.0F};
    float angle_bias{BalanceCompensation::default_minimum_bias_degrees};
    float pitch_error{};
    float roll_angle{};
    int left_pwm{};
    int right_pwm{};
    bool armed{};
    bool imu_valid{};
    uint32_t loop_count{};
    uint32_t sample_tick{};
    uint32_t max_sample_gap_ticks{};
    uint32_t deadline_misses{};
    bool remote_timed_out{};
    float velocity_target{};
    float difference_target{};
    float roll_target{};
    bool auto_leg_active{};
};

// Value types above are portable; the snapshot implementation is single-core
// FreeRTOS. Only commands write parameters; only motion writes feedback/legs.
// Callers receive copies, never mutable references to shared state.
class ControlState final {
public:
    [[nodiscard]] ControlParameters parameters() const;
    void set_parameters(const ControlParameters& parameters);
    [[nodiscard]] ControlFeedback feedback() const;
    void publish_feedback(const ControlFeedback& feedback);
    [[nodiscard]] LegTargets leg_targets() const;
    void publish_leg_targets(LegTargets targets);
    [[nodiscard]] bool begin_storage(bool exclusive);
    void end_storage();
    [[nodiscard]] bool storage_busy() const;
    [[nodiscard]] bool storage_blocks_control() const;
    [[nodiscard]] bool consume_storage_reset();
    void request_control_reset();
    void set_installation_mode(bool enabled);
    [[nodiscard]] bool installation_mode() const;
    void set_installation_ready(bool ready);
    [[nodiscard]] bool installation_ready() const;

private:
    ControlParameters parameters_{};
    ControlFeedback feedback_{};
    LegTargets leg_targets_{};
    MotionStorageInterlock storage_interlock_{};
    bool installation_mode_{};
    bool installation_ready_{};
};

} // namespace app
