lk888l/wheeled-legged_Robot-WL1/car_firmware/Component/UserApp/CtrlAlgorithm/LegKinematics.cpp

/********************************************************************************
  * @file           : LegKinematics.cpp
  * @author         : Luka
  * @brief          : None
  * @attention      : None
  * @date           : 26-4-15
  *******************************************************************************/


#include "LegKinematics.hpp"
