lk888l/wheeled-legged_Robot-WL1/car_firmware/tests/runtime_tuning_test.cpp

#include <cmath>
#include <cstdio>
#include <functional>
#include <limits>
#include <string>
#include "BoardHardware.hpp"
#include "ControlState.hpp"
#include "RuntimeStatus.hpp"
#include "Tasks/ButtonTask.hpp"
#include "Tasks/CommandServiceTask.hpp"
#include "Tasks/MotionControlTask.hpp"
#include "test_check.hpp"
#include "PersistentFlash.hpp"

namespace {
std::function<void()> step;
void advance() { step(); }
class ServoPeer final : public app::AppTask {
public:
    ServoPeer() : AppTask(app::task_config::servo) {}
private:
    void run() override { throw fake_rtos::LoopDone{}; }
};

struct Fixture {
    bsp::BoardHardware board;
    app::ControlState control;
    app::RuntimeStatus status;
    app::ButtonEventQueue events;
    app::ButtonTask button{board, events};
    app::CommandServiceTask command{board, status, control, button, events};
    ServoPeer servo;
    app::MotionControlTask motion{board, status, control, servo};
    TaskFunction_t command_entry{};
    void* command_argument{};

    Fixture()
    {
        fake_rtos::reset();
        status.reset();
        app::InitializationReport report;
        report.attempted_mask = 0xFFU;
        status.publish_initialization_report(report);
        status.enable_control(true);
        status.set_state(app::SystemState::ready);
        CHECK(command.start());
        command_entry = fake_rtos::entry;
        command_argument = fake_rtos::argument;
        CHECK(servo.start());
    }
    void send(const std::string& text, bool radio = true)
    {
        if (radio) { NRF24L01P::str_touint8(text.c_str(), board.radio().received.data()); }
        else { board.command_uart().received = text.c_str(); }
        fake_rtos::pending_notifications = radio ? 2U : 1U;
        try { command_entry(command_argument); CHECK(false); }
        catch (const fake_rtos::LoopDone&) {}
    }
    void run()
    {
        fake_rtos::on_delay = advance;
        fake_rtos::run_on_resume = true;
        try { (void)motion.start(); CHECK(false); }
        catch (const fake_rtos::LoopDone&) {}
        CHECK(fake_rtos::critical_depth == 0);
    }
};

void test_each_gain()
{
    // Analytic step responses of the real command -> snapshot -> task -> PWM/leg path.
    for (const std::string loop : {"anglepid", "velocitypid", "differpid", "rollpid"}) {
        for (const char term : {'p', 'i', 'd'}) {
            Fixture f;
            auto parameters = f.control.parameters();
            parameters.angle = {10, 0, 0};
            parameters.angle_kp_auto = false;
            parameters.velocity = parameters.difference = parameters.roll = {0, 0, 0};
            parameters.leg_height = 61.5F;
            f.control.set_parameters(parameters);
            f.board.imu().reading.Pitch = -BalanceCompensation::pitchBias(parameters.angle_bias, 61.5F);
            const unsigned end = loop == "anglepid" ? 520U : 560U;
            step = [&] {
                const auto tick = fake_rtos::now;
                if (tick < 510U) {
                    CHECK(f.board.wheel_motor().left == 0 && f.board.wheel_motor().right == 0);
                    if (tick <= 500U) { CHECK(!f.control.feedback().armed); }
                }
                if (tick == 510U) {
                    CHECK(f.control.feedback().armed);
                    if (loop == "anglepid") {
                        f.send("anglepid -p 0");
                        f.board.imu().reading.Pitch -= 1.0;
                    } else if (loop == "velocitypid") {
                        f.board.left_encoder().rpm = f.board.right_encoder().rpm = 1;
                    } else if (loop == "differpid") {
                        f.board.left_encoder().rpm = 1;
                        f.board.right_encoder().rpm = -1;
                    } else {
                        f.board.imu().reading.Roll = 1;
                    }
                    f.send(loop + " -" + term + " 1");
                }
                if (tick == end) {
                    CHECK(f.control.feedback().armed);
                    if (loop == "anglepid") {
                        CHECK(f.board.wheel_motor().left == 1 && f.board.wheel_motor().right == 1);
                    } else if (loop == "velocitypid") {
                        CHECK(f.board.wheel_motor().left == -10 && f.board.wheel_motor().right == -10);
                    } else if (loop == "differpid") {
                        CHECK(f.board.wheel_motor().left == -2 && f.board.wheel_motor().right == 2);
                    } else {
                        const auto legs = f.control.leg_targets();
                        CHECK(std::fabs(legs.left - 62.5F) < 0.0001F);
                        CHECK(std::fabs(legs.right - 60.5F) < 0.0001F);
                    }
                    throw fake_rtos::LoopDone{};
                }
            };
            f.run();
        }
    }
}

void test_calibration_and_recovery()
{
    Fixture f;
    f.send("anglepid -d 0");
    step = [&] {
        const auto tick = fake_rtos::now;
        if (tick == 510U) {
            CHECK(f.control.feedback().armed);
            CHECK(f.board.wheel_motor().a_deadzone == MotionSettings::default_motor_deadzone);
            CHECK(f.board.wheel_motor().b_deadzone == MotionSettings::default_motor_deadzone);
            f.send("deadzone 75", false);
            CHECK(std::fabs(f.control.feedback().angle_kp - 70.25F) < 0.0001F);
            f.send("anglepid -p 80");
            f.send("R 0 0 0 61.5");
        }
        if (tick == 560U) {
            CHECK(f.board.wheel_motor().a_deadzone == 75U);
            CHECK(f.board.wheel_motor().b_deadzone == 75U);
            CHECK(f.control.feedback().angle_kp == 80);
            CHECK(std::fabs(f.control.feedback().angle_bias -
                BalanceCompensation::pitchBias(
                    BalanceCompensation::default_minimum_bias_degrees, 61.5F)) < 0.0001F);
            f.send("anglebias 10.5", false);
            f.board.imu().reading.Roll = 4;
        }
        if (tick == 710U) {
            const auto legs = f.control.leg_targets();
            CHECK(legs.left != legs.right);
            CHECK(std::fabs((legs.left + legs.right) / 2 - 61.5F) < 0.0001F);
            CHECK(std::fabs(f.control.feedback().angle_bias - 7.60252F) < 0.0001F);
            CHECK(f.control.feedback().angle_kp == 80);
            CHECK(f.control.parameters().angle_bias == 10.5F);
            f.send("anglepid -p nan");
            f.send("anglebias inf");
            CHECK(f.control.parameters().angle.kp == 80 && f.control.parameters().angle_kp_auto);
            CHECK(f.control.parameters().angle_bias == 10.5F);
            f.send("anglepid -auto");
        }
        if (tick == 720U) {
            CHECK(std::fabs(f.control.feedback().angle_kp - 80.0F) < 0.0001F);
            f.board.imu().healthy = false;
        }
        if (tick == 730U) {
            CHECK(!f.control.feedback().armed && !f.control.feedback().imu_valid);
            CHECK(f.board.wheel_motor().left == 0 && f.board.wheel_motor().right == 0);
            f.board.imu().healthy = true;
            f.board.imu().reading = {0, -7.60252, 0};
        }
        if (tick > 730U && tick <= 1220U) { CHECK(!f.control.feedback().armed); }
        if (tick == 1230U) {
            CHECK(f.control.feedback().armed);
            f.board.imu().reading.Pitch = 40;
        }
        if (tick == 1240U) {
            CHECK(!f.control.feedback().armed && f.board.wheel_motor().left == 0);
            f.board.imu().reading.Pitch = std::numeric_limits<double>::quiet_NaN();
        }
        if (tick == 1270U) {
            CHECK(f.status.state() == app::SystemState::runtime_fault);
            CHECK(!f.status.control_enabled());
            CHECK(f.board.safe_stops == 1U);
            CHECK(f.control.feedback().max_sample_gap_ticks == 10U);
            CHECK(f.control.feedback().deadline_misses == 0U);
            throw fake_rtos::LoopDone{};
        }
    };
    f.run();
}
void test_remote_timeout()
{
    Fixture f;
    f.send("rollbias -4", false);
    f.board.imu().reading.Roll = 4.0;
    step = [&] {
        const auto tick = fake_rtos::now;
        if (tick == 510U) {
            CHECK(f.control.feedback().armed);
            f.send("@R 10 20 4 61.5\n", false);
        }
        if (tick == 520U) {
            CHECK(f.control.feedback().velocity_target == 20);
            CHECK(f.control.feedback().difference_target == 10);
        }
        if (tick == 900U) {
            f.send("@anglepid -p 80\n", false);
            f.send("@rollbias -5\n", false);
            f.board.imu().reading.Roll = 5.0;
            CHECK(f.control.parameters().motion_command_tick == 510U);
        }
        if (tick == 1010U) { CHECK(!f.control.feedback().remote_timed_out); }
        if (tick == 1020U) {
            const auto feedback = f.control.feedback();
            CHECK(feedback.remote_timed_out && feedback.armed && feedback.imu_valid);
            CHECK(feedback.velocity_target == 0 && feedback.difference_target == 0 && feedback.roll_target == 0);
            CHECK(f.control.parameters().leg_height == 61.5F);
            CHECK(f.control.parameters().roll_bias == -5.0F && feedback.roll_angle == 0.0F);
            CHECK(feedback.angle_kp == 80 && feedback.deadline_misses == 0U);
            CHECK(f.status.control_enabled());
            // Tuning and malformed commands do not extend the motion deadline.
            f.send("@R 10 invalid 4 61.5\n", false);
            CHECK(f.control.parameters().motion_command_tick == 510U);
        }
        if (tick == 1050U) {
            f.send("target_roll 6", false);
            CHECK(f.control.parameters().velocity_target == 0 && f.control.parameters().difference_target == 0);
        }
        if (tick == 1060U) {
            CHECK(!f.control.feedback().remote_timed_out && f.control.feedback().roll_target == 6);
            CHECK(f.control.feedback().velocity_target == 0);
            CHECK(f.control.parameters().roll_bias == -5.0F);
            f.send("@R 999 -999 -99 99\n", false);
            const auto p = f.control.parameters();
            CHECK(p.difference_target == 100 && p.velocity_target == -100 && p.roll_target == -18 && p.leg_height == 78.5F);
            CHECK(p.roll_bias == -5.0F);
            throw fake_rtos::LoopDone{};
        }
    };
    f.run();
}

void test_recycle_at_arming_boundary()
{
    fake_flash::reset();
    Fixture f;
    bool saved = false;
    // At sample 50 the local gate has armed, but the shared feedback still
    // describes sample 49. Simulate the command task preempting encoder I/O.
    f.board.left_encoder().on_read = [&] {
        if (fake_rtos::now == 500U && !saved) {
            CHECK(!f.control.feedback().armed);
            f.send("save recycle", false);
            CHECK(fake_flash::device.writes == 21U);
            saved = true;
        }
    };
    step = [&] {
        if (fake_rtos::now == 510U) {
            CHECK(saved && !f.control.storage_busy());
            CHECK(f.board.wheel_motor().writes == 0U);
        }
        if (fake_rtos::now <= 1000U) {
            CHECK(!f.control.feedback().armed);
            CHECK(f.board.wheel_motor().left == 0 && f.board.wheel_motor().right == 0);
        }
        if (fake_rtos::now == 1010U) {
            CHECK(f.control.feedback().armed);
            CHECK(f.status.control_enabled());
            f.send("control off", false);
        }
        if (fake_rtos::now == 1020U) {
            CHECK(!f.control.feedback().armed);
            CHECK(f.board.wheel_motor().left == 0 && f.board.wheel_motor().right == 0);
            f.send("save", false);
            CHECK(!f.status.control_enabled());
            f.send("control on", false);
        }
        if (fake_rtos::now > 1020U && fake_rtos::now <= 1510U) {
            CHECK(!f.control.feedback().armed);
        }
        if (fake_rtos::now == 1520U) {
            CHECK(f.control.feedback().armed);
            // Both commands arrive between two motion ticks.
            f.send("control off", false);
            f.send("control on", false);
        }
        if (fake_rtos::now > 1520U && fake_rtos::now <= 2010U) {
            CHECK(!f.control.feedback().armed);
        }
        if (fake_rtos::now == 2020U) {
            CHECK(f.control.feedback().armed);
            throw fake_rtos::LoopDone{};
        }
    };
    f.run();
}

void test_append_keeps_balancing()
{
    fake_flash::reset();
    Fixture f;
    f.send("anglepid -d 0");
    step = [&] {
        const auto tick = fake_rtos::now;
        if (tick == 510U) {
            CHECK(f.control.feedback().armed);
            f.board.imu().reading.Pitch -= 1.0;
            // The storage owner remains busy while the real motion task runs.
            CHECK(f.control.begin_storage(false));
        }
        if (tick >= 520U && tick <= 570U) {
            CHECK(f.control.storage_busy() && !f.control.storage_blocks_control());
            CHECK(f.control.feedback().armed && f.status.control_enabled());
            CHECK(f.board.wheel_motor().left != 0 && f.board.wheel_motor().right != 0);
        }
        if (tick == 570U) {
            f.control.end_storage();
            const auto before = f.control.feedback();
            fake_flash::device.on_yield = [&] {
                CHECK(f.control.storage_busy() && !f.control.storage_blocks_control());
                CHECK(f.control.feedback().armed && !f.control.consume_storage_reset());
            };
            f.send("save", false);
            CHECK(fake_flash::device.writes == 21U && fake_flash::device.yields == 21U);
            CHECK(f.control.feedback().left_pwm == before.left_pwm);
            CHECK(!f.control.consume_storage_reset());
        }
        if (tick == 580U) {
            CHECK(f.control.feedback().armed && f.board.wheel_motor().left != 0);
            CHECK(f.control.feedback().deadline_misses == 0U);
            f.send("save recycle", false);
            CHECK(fake_flash::device.erases == 0U && f.control.feedback().armed);
            throw fake_rtos::LoopDone{};
        }
    };
    f.run();
}

void test_control_off_keeps_attitude_tracking()
{
    Fixture f;
    f.send("rollbias -4", false);
    f.board.imu().reading.Roll = 4.0;
    f.send("control off", false);
    step = [&] {
        const auto tick = fake_rtos::now;
        if (tick > 10U) {
            // Every completed iteration must have consumed a fresh IMU sample,
            // including the two seconds when outputs are explicitly disabled.
            CHECK(f.board.imu().samples.size() == tick / 10U - 1U);
            CHECK(f.board.imu().fusion_resets == 0U);
            CHECK(f.control.parameters().roll_bias == -4.0F);
            CHECK(f.control.feedback().roll_angle == 0.0F);
        }
        if (tick <= 2010U) {
            CHECK(!f.control.feedback().armed);
            CHECK(f.board.wheel_motor().left == 0 && f.board.wheel_motor().right == 0);
        }
        if (tick == 1000U) f.board.imu().reading.Pitch = -8.5;
        if (tick == 1010U) {
            CHECK(f.control.feedback().imu_valid);
            CHECK(f.control.feedback().euler[1] == -8.5F);
        }
        if (tick == 2010U) f.send("control on", false);
        if (tick > 2010U && tick < 2510U) CHECK(!f.control.feedback().armed);
        if (tick == 2510U) {
            CHECK(f.control.feedback().armed);
            CHECK(f.board.imu().fusion_resets == 0U);
            f.send("control off", false);
        }
        if (tick == 2520U) {
            CHECK(!f.control.feedback().armed);
            CHECK(f.board.wheel_motor().left == 0 && f.board.wheel_motor().right == 0);
            throw fake_rtos::LoopDone{};
        }
    };
    f.run();
}

void test_auto_leg_switch()
{
    Fixture f;
    f.send("rollbias -7", false);
    f.board.imu().reading.Roll = 7.0;
    auto parameters = f.control.parameters();
    parameters.leg_height = 61.5F;
    parameters.roll = {0.0F, 0.0F, 0.0F};
    f.control.set_parameters(parameters);
    f.board.imu().reading.Pitch = -BalanceCompensation::pitchBias(parameters.angle_bias, 61.5F);
    float full_adjustment{};
    step = [&] {
        const auto tick = fake_rtos::now;
        if (tick == 510U) {
            CHECK(f.control.feedback().armed && f.control.feedback().auto_leg_active);
            f.board.imu().reading.Roll = 11.0;
        }
        if (tick == 560U) {
            const auto legs = f.control.leg_targets();
            full_adjustment = std::fabs(legs.left - legs.right);
            CHECK(full_adjustment > 0.5F);
            f.send("autoleg off", false);
            CHECK(!f.control.parameters().auto_leg_enabled);
            CHECK(f.control.parameters().roll_bias == -7.0F);
            CHECK(f.board.command_uart().logs.back() == "autoleg: enabled=0 active=0\n");
        }
        if (tick == 610U) {
            const auto legs = f.control.leg_targets();
            CHECK(legs.left == 61.5F && legs.right == 61.5F);
            CHECK(!f.control.feedback().auto_leg_active);
            f.send("autoleg on", false);
            CHECK(f.control.parameters().roll_bias == -7.0F);
            CHECK(f.board.command_uart().logs.back() == "autoleg: enabled=1 active=0\n");
        }
        if (tick == 660U || tick == 710U) {
            const auto legs = f.control.leg_targets();
            const float adjustment = std::fabs(legs.left - legs.right);
            const float fraction = tick == 660U ? 0.1F : 0.2F;
            CHECK(std::fabs(adjustment - full_adjustment * fraction) < 0.0005F);
            CHECK(f.control.feedback().auto_leg_active);
            if (tick == 660U) {
                f.send("autoleg status", false);
                CHECK(f.board.command_uart().logs.back() == "autoleg: enabled=1 active=1\n");
            }
        }
        if (tick == 1110U) {
            const auto legs = f.control.leg_targets();
            CHECK(std::fabs(std::fabs(legs.left - legs.right) - full_adjustment) < 0.0005F);
            throw fake_rtos::LoopDone{};
        }
    };
    f.run();
}

void test_roll_calibration_controls_legs_and_gate()
{
    Fixture f;
    auto parameters = f.control.parameters();
    parameters.leg_height = 61.5F;
    parameters.roll = {1.0F, 0.0F, 0.0F};
    f.control.set_parameters(parameters);
    f.board.imu().reading.Pitch = -BalanceCompensation::pitchBias(parameters.angle_bias, 61.5F);
    f.board.imu().reading.Roll = 7.0;
    f.send("rollbias -7", false);
    step = [&] {
        const auto tick = fake_rtos::now;
        if (tick >= 510U && tick <= 760U) CHECK(f.control.feedback().armed);
        if (tick == 510U) {
            // Raw roll exceeds the startup limit, but its calibrated midpoint is level.
            CHECK(f.control.feedback().euler[0] == 7.0F);
            CHECK(f.control.feedback().roll_angle == 0.0F);
            CHECK(f.control.leg_targets().left == 61.5F && f.control.leg_targets().right == 61.5F);
            f.send("showimu -y", false);
        }
        if (tick == 520U) {
            float raw_roll{}, raw_pitch{}, raw_yaw{};
            CHECK(std::sscanf(f.board.command_uart().logs.back().c_str(), "%f,%f,%f",
                              &raw_roll, &raw_pitch, &raw_yaw) == 3);
            CHECK(raw_roll == 7.0F && raw_yaw == 0.0F);
            CHECK(std::fabs(raw_pitch - f.control.feedback().euler[1]) < 0.0001F);
            f.send("showimu -n", false);
            f.board.imu().reading.Roll = 8.0;
        }
        if (tick == 560U) {
            const auto legs = f.control.leg_targets();
            CHECK(f.control.feedback().roll_angle == 1.0F);
            CHECK(std::fabs(legs.left - 62.5F) < 0.0001F);
            CHECK(std::fabs(legs.right - 60.5F) < 0.0001F);
            f.board.imu().reading.Roll = 12.0;
        }
        if (tick == 610U) {
            const auto legs = f.control.leg_targets();
            // Five corrected degrees produce five PID units plus the geometry
            // beyond the three-degree deadband, independently of raw roll=12.
            const float adjustment = 5.0F + 27.5F * std::sin(2.0F * 0.0174532925F);
            CHECK(std::fabs(legs.left - (61.5F + adjustment)) < 0.0001F);
            CHECK(std::fabs(legs.right - (61.5F - adjustment)) < 0.0001F);
            f.send("rollpid -p 0", false);
            f.send("rollpid -i 1", false);
        }
        if (tick == 710U) {
            CHECK(f.control.leg_targets().left - f.control.leg_targets().right > 20.0F);
            // The integral has accumulated at the old midpoint. Calibration
            // must clear that history without restarting the vehicle's gate.
            f.send("rollbias -12", false);
        }
        if (tick == 760U) {
            CHECK(f.control.feedback().roll_angle == 0.0F);
            CHECK(f.control.feedback().euler[0] == 12.0F);
            CHECK(f.control.leg_targets().left == 61.5F && f.control.leg_targets().right == 61.5F);
            f.board.imu().reading.Roll = -0.25;
            f.send("rollbias -0.5", false);
            f.send("showimu -y", false);
        }
        if (tick == 770U) {
            float raw_roll{}, raw_pitch{}, raw_yaw{};
            CHECK(std::sscanf(f.board.command_uart().logs.back().c_str(), "%f,%f,%f",
                              &raw_roll, &raw_pitch, &raw_yaw) == 3);
            CHECK(raw_roll == -0.25F && raw_yaw == 0.0F);
            CHECK(f.control.feedback().roll_angle == -0.75F);
            CHECK(f.control.feedback().armed);
            f.send("showimu -n", false);
            f.board.imu().reading.Roll = 0.0;
            f.send("rollbias -31", false);
        }
        if (tick == 780U) {
            // A raw zero cannot bypass the tipping gate when calibrated roll is unsafe.
            CHECK(f.control.feedback().roll_angle == -31.0F);
            CHECK(!f.control.feedback().armed);
            CHECK(f.board.wheel_motor().left == 0 && f.board.wheel_motor().right == 0);
            throw fake_rtos::LoopDone{};
        }
    };
    f.run();
}

void test_roll_calibration_can_block_startup()
{
    Fixture f;
    f.send("rollbias 7", false);
    step = [&] {
        const auto tick = fake_rtos::now;
        if (tick <= 610U) {
            CHECK(!f.control.feedback().armed);
            CHECK(f.board.wheel_motor().left == 0 && f.board.wheel_motor().right == 0);
        }
        if (tick == 610U) {
            CHECK(f.control.feedback().euler[0] == 0.0F);
            CHECK(f.control.feedback().roll_angle == 7.0F);
            f.send("rollbias 0", false);
        }
        if (tick > 610U && tick < 1110U) CHECK(!f.control.feedback().armed);
        if (tick == 1110U) {
            CHECK(f.control.feedback().armed && f.control.feedback().roll_angle == 0.0F);
            throw fake_rtos::LoopDone{};
        }
    };
    f.run();
}
} // namespace

int main()
{
    test_each_gain();
    test_calibration_and_recovery();
    test_remote_timeout();
    test_recycle_at_arming_boundary();
    test_append_keeps_balancing();
    test_control_off_keeps_attitude_tracking();
    test_auto_leg_switch();
    test_roll_calibration_controls_legs_and_gate();
    test_roll_calibration_can_block_startup();
}
