lk888l/wheeled-legged_Robot-WL1/car_firmware/tests/command_service_test.cpp

#include <algorithm>
#include <cstdio>
#include <cstring>
#include "BoardHardware.hpp"
#include "ControlState.hpp"
#include "RuntimeStatus.hpp"
#include "Tasks/ButtonTask.hpp"
#include "Tasks/CommandServiceTask.hpp"
#include "test_check.hpp"

namespace {
unsigned idle_waits{};
BaseType_t run_one_period()
{
    if (idle_waits++ == 0U) { fake_rtos::now += 100U; return pdFALSE; }
    throw fake_rtos::LoopDone{};
}
}

int main()
{
    fake_rtos::reset();
    bsp::BoardHardware board;
    app::ControlState control;
    app::RuntimeStatus status;
    status.reset();
    app::InitializationReport report;
    report.attempted_mask = 0xFFU;
    status.publish_initialization_report(report);
    app::ButtonEventQueue events;
    app::ButtonTask button(board, events);
    app::CommandServiceTask command(board, status, control, button, events);
    CHECK(command.start());
    const auto entry = fake_rtos::entry;
    void* const argument = fake_rtos::argument;

    // Execute the real task body with test-only notification and I/O adapters.
    auto dispatch = [&](const char* text, bool radio = false, bool periodic = false) {
        if (radio) { NRF24L01P::str_touint8(text, board.radio().received.data()); }
        else { board.command_uart().received = text; }
        fake_rtos::pending_notifications = radio ? 2U : 1U;
        idle_waits = 0U;
        fake_rtos::on_wait = periodic ? run_one_period : nullptr;
        try { entry(argument); CHECK(false); }
        catch (const fake_rtos::LoopDone&) {}
        CHECK(fake_rtos::critical_depth == 0);
    };

    CHECK(control.parameters().angle_bias == BalanceCompensation::default_minimum_bias_degrees);
    CHECK(control.parameters().roll_bias == 0.0F);
    CHECK(control.parameters().motor_deadzone == MotionSettings::default_motor_deadzone);
    // Both command transports must preserve the last valid baseline on every
    // rejected number, including numeric overflow and extra arguments.
    for (const bool radio : {false, true}) {
        dispatch(radio ? "anglebias -3.5" : "anglebias 11.25", radio);
        const float baseline = radio ? -3.5F : 11.25F;
        CHECK(control.parameters().angle_bias == baseline);
        for (const char* invalid : {"anglebias", "anglebias invalid", "anglebias nan",
                 "anglebias NaN", "anglebias inf", "anglebias -inf", "anglebias Infinity",
                 "anglebias 1e39", "anglebias -1e999", "anglebias 12junk",
                 "anglebias 12 13", "anglebias auto"}) {
            dispatch(invalid, radio);
            CHECK(control.parameters().angle_bias == baseline);
        }
        dispatch("R 0 0 0 55", radio);
        CHECK(control.parameters().angle_bias == baseline);
    }

    for (const bool radio : {false, true}) {
        dispatch(radio ? "rollbias -3.5" : "rollbias 2.25", radio);
        const float baseline = radio ? -3.5F : 2.25F;
        CHECK(control.parameters().roll_bias == baseline);
        for (const char* invalid : {"rollbias invalid", "rollbias nan", "rollbias NaN",
                 "rollbias inf", "rollbias -inf", "rollbias Infinity", "rollbias 1e39",
                 "rollbias -1e999", "rollbias 12junk", "rollbias 12 13", "rollbias auto"}) {
            dispatch(invalid, radio);
            CHECK(control.parameters().roll_bias == baseline);
            CHECK(board.command_uart().logs.back().find("invalid parameters") != std::string::npos);
        }
        dispatch("R 0 0 5 55", radio);
        dispatch("target_roll -8", radio);
        CHECK(control.parameters().roll_bias == baseline);
        CHECK(control.parameters().roll_target == -8.0F);
    }
    app::ControlFeedback roll_feedback;
    roll_feedback.euler[0] = 5.0F;
    roll_feedback.roll_angle = 1.5F;
    control.publish_feedback(roll_feedback);
    const auto check_roll_status = [](const std::string& text, float expected_base,
                                      float expected_raw = 5.0F, float expected_effective = 1.5F) {
        float base{}, raw{}, effective{};
        CHECK(std::sscanf(text.c_str(), "rollbias base=%f raw=%f effective=%f",
                          &base, &raw, &effective) == 3);
        CHECK(base == expected_base && raw == expected_raw && effective == expected_effective);
    };
    dispatch("rollbias", true);
    check_roll_status(board.command_uart().logs.back(), -3.5F);
    // A setting change does not invent a new sensor sample for diagnostics.
    dispatch("rollbias -4", false);
    dispatch("rollbias", false);
    check_roll_status(board.command_uart().logs.back(), -4.0F);
    const std::string roll_status = board.command_uart().logs.back();
    const auto before_params = board.command_uart().logs.size();
    dispatch("params");
    CHECK(std::find(board.command_uart().logs.begin() + before_params,
                    board.command_uart().logs.end(), roll_status) != board.command_uart().logs.end());
    // Sub-degree negative values must retain their sign in all displayed fields.
    dispatch("rollbias -0.5");
    roll_feedback.euler[0] = -0.25F;
    roll_feedback.roll_angle = -0.75F;
    control.publish_feedback(roll_feedback);
    dispatch("rollbias");
    check_roll_status(board.command_uart().logs.back(), -0.5F, -0.25F, -0.75F);
    const std::string negative_roll_status = board.command_uart().logs.back();
    const auto before_negative_params = board.command_uart().logs.size();
    dispatch("params");
    CHECK(std::find(board.command_uart().logs.begin() + before_negative_params,
                    board.command_uart().logs.end(), negative_roll_status) != board.command_uart().logs.end());

    dispatch("R 10 20 5 60\r\n");
    auto parameters = control.parameters();
    CHECK(parameters.difference_target == 10.0F && parameters.velocity_target == 20.0F);
    CHECK(parameters.roll_target == 5.0F && parameters.leg_height == 60.0F);
    dispatch("R 30 40 invalid 70");
    parameters = control.parameters();
    CHECK(parameters.difference_target == 10.0F && parameters.velocity_target == 20.0F);
    CHECK(parameters.leg_height == 60.0F);
    dispatch("VandD 1 2 junk");
    CHECK(control.parameters().velocity_target == 20.0F);
    dispatch("VandD\t3\t4");
    CHECK(control.parameters().difference_target == 3.0F && control.parameters().velocity_target == 4.0F);

    dispatch("rollpid -p 1.25");
    CHECK(control.parameters().roll.kp == 1.25F && control.parameters().roll.ki == -0.4F);
    dispatch("rollpid -i -0.5");
    CHECK(control.parameters().roll.ki == -0.5F);
    dispatch("anglepid -d 55");
    CHECK(control.parameters().angle.kd == 55.0F);
    dispatch("anglepid -d");
    dispatch("anglepid -d nan");
    dispatch("anglepid -d 1junk");
    CHECK(control.parameters().angle.kd == 55.0F);
    dispatch("showimu -y");
    CHECK(control.parameters().show_imu);
    dispatch("showimu invalid");
    CHECK(control.parameters().show_imu);
    dispatch("showimu -n");
    CHECK(!control.parameters().show_imu);
    dispatch("target_roll 8");
    CHECK(control.parameters().roll_target == 8.0F);
    dispatch("legheight 50");
    CHECK(control.parameters().leg_height == 50.0F);
    dispatch("legheight 60                     extra");
    CHECK(control.parameters().leg_height == 50.0F);
    dispatch("deadzone 75");
    CHECK(control.parameters().motor_deadzone == 75U);
    for (const char* invalid : {"deadzone -1", "deadzone 1001", "deadzone 1.5",
                                "deadzone 50junk", "deadzone 50 60"}) {
        dispatch(invalid);
        CHECK(control.parameters().motor_deadzone == 75U);
    }
    dispatch("deadzone", true);
    CHECK(board.command_uart().logs.back().find("deadzone=75") != std::string::npos);
    dispatch("deadzone 0", true);
    CHECK(control.parameters().motor_deadzone == 0U);
    dispatch("motor 100 100");
    CHECK(board.command_uart().logs.back().find("raw PWM is unavailable") != std::string::npos);
    dispatch("ping");
    CHECK(board.command_uart().logs.back().find("pong") != std::string::npos);
    dispatch("uid");
    CHECK(board.command_uart().logs.back() == "uid: 0123456789ABCDEF10203040\n");
    dispatch("@uid\n");
    CHECK(board.command_uart().logs.back() == "uid: 0123456789ABCDEF10203040\n");
    dispatch("uid extra", true);
    CHECK(board.command_uart().logs.back() == "uid: usage: uid\n");
    dispatch("uid", true);
    CHECK(board.command_uart().logs.back() == "uid: 0123456789ABCDEF10203040\n");

    const auto log_count = board.command_uart().logs.size();
    const auto motion_tick = control.parameters().motion_command_tick;
    for (const char* reply : {"OK\r\n", "ERROR\r\n", "FAIL\r\n",
             "OK+G_VERS=V1.7.9\r\n", "OK+G_BAUD=3\r\n", "+OK\r\n", "+ER\r\n"}) {
        dispatch(reply);
        CHECK(board.command_uart().logs.size() == log_count);
        CHECK(control.parameters().motion_command_tick == motion_tick);
    }

    dispatch("R 5 6 7 55", true);
    CHECK(control.parameters().velocity_target == 6.0F && control.parameters().leg_height == 55.0F);
    board.radio().receive_ok = false;
    dispatch("R 90 90 90 90", true);
    CHECK(control.parameters().velocity_target == 6.0F);
    control.publish_feedback({{1.0F, 2.0F, 3.0F}, 70.0F, 12.6F});
    dispatch("nrfshow -mr 0", false, true);
    CHECK(board.radio().sent.size() == 1U);
    CHECK(std::strcmp(reinterpret_cast<const char*>(board.radio().sent.back().data()),
                       " 1.0 2.0 3.0 70.0") == 0);
    dispatch("nrfshow -nn", false, true);
    CHECK(board.radio().sent.size() == 1U);

    CHECK(events.push({app::Button::Event::click, 10U}));
    CHECK(events.push({app::Button::Event::double_click, 20U}));
    CHECK(events.push({app::Button::Event::long_press, 30U}));
    dispatch("button");
    CHECK(board.command_uart().logs.back().find("click=1 double=1 long=1 drop=0") != std::string::npos);
    CHECK(fake_rtos::notifications == 0U);
}
