lk888l/wheeled-legged_Robot-WL1/car_firmware/tests/test_check.hpp

#pragma once
#include <cstdlib>
#include <iostream>

#define CHECK(expression) do { if (!(expression)) { \
    std::cerr << __FILE__ << ':' << __LINE__ << ": " #expression " failed\n"; \
    std::exit(EXIT_FAILURE); \
} } while (false)
