lk888l/wheeled-legged_Robot-WL1/(commit log)

2026-03-01 create original version
    [STlink.cfg]
2026-03-05 basic of develop version
    [STlink.cfg]
2026-03-14 The version before replacing the motor.
2026-03-21 add experiment Uart-Class
2026-04-20 pid version
2026-07-11 add tele_firmware.
    [STlink.cfg]
2026-07-24 fix bug of telecontrol
    [NRF24L01P.cpp, NRF24L01P.hpp, main.cpp]
2026-07-26 fix remote-control and add some secondary file
    [HallEncoder.cpp, HallEncoder.h, LQR.cpp, LQR.hpp, LegKinematics.cpp]
2026-09-06 Improve balance startup and add UART radio control
    - Require 500 ms of valid, stable attitude and neutral speed/turn
    targets before enabling balance control. Reset controllers and
    stop wheel output on invalid IMU data or excessive tilt.
    - Preserve VQF NaN initialization semantics by replacing -Ofast with
    -O3 -fno-fast-math and rejecting incompatible compiler options.
    Move sensor I/O outside the control loop's critical section.
    - Suppress PID derivative spikes on the first sample after startup
    or reset, and keep zero motor commands at zero PWM.
    - Preserve the configurable anglebias baseline across height changes.
    Compute compensation from both bounded leg targets and share
    consi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
    [BalanceCompensation.hpp, BalanceStartupGate.hpp, LkUart.cpp, LkUart.hpp, NRF24L01P.cpp, NRF24L01P.hpp, PID.hpp, TB6612.cpp]
2026-09-13 feat: modularize firmware and enhance runtime control
    improves the overall firmware architecture, runtime control capabilities, and operational safety.
    - Refactor the car firmware into clearer application, hardware, and task modules.
    - Improve hardware initialization, runtime status reporting, and balance startup safety.
    - Add runtime balance parameter tuning through remote-control commands.
    - Add UART-to-radio command bridging for the remote-control firmware.
    - Add ZX-D30 Bluetooth UART support and improve UART communication handling.
    - Add comprehensive host-side tests for startup, control, commands, UART, and runtime tuning.
    - Update architecture, command, debugging, and hardware integrat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
    [STlink.cfg, STlink_hla.cfg]
2026-09-13 feat: persist motion parameters to internal flash
    - Add save/save all to persist motion tunings and posture targets,
    and restore the latest valid configuration before starting control tasks.
    - Reserve Flash sector 7 for a versioned append-only journal with CRC32,
    readback verification and a final commit marker.
    - Skip unchanged saves and require explicit save recycle when storage is full.
    - Keep speed, steering, motor outputs and controller history transient.
    - Tune angle Kp at the 61.5 mm reference height while preserving the
    existing linear height compensation and default effective gains.
    - Fix rollpid -p, add roll/leg derivative tuning and the legpid alias.
    - Add params diagnostics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
    [MotionParameterCommands.hpp, MotionParameterJournal.hpp, MotionParameterStorage.cpp, MotionParameterStorage.hpp, MotionParameters.hpp, MotionStorageInterlock.hpp, PID.hpp, balance_compensation_test.cpp]
2026-09-13 feat: allow saving motion parameters while balancing
    Allow save and save all to persist motion parameters without disabling
    balance control or resetting PID history.
    - Load saved parameters into RAM at startup and keep runtime tuning in RAM
    until an explicit save command writes a parameter snapshot to Flash.
    - Separate normal append writes from exclusive erase operations.
    - Yield for one RTOS tick after each programmed 32-bit word so the
    higher-priority motion task can run between writes.
    - Preserve the existing Flash layout, CRC checks, commit markers, and
    compatibility with v1 and v2 parameter records.
    - Return full without erasing when the journal has no available slots.
    Keep sav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
    [CommandServiceTask.cpp, ControlState.cpp, ControlState.hpp, MotionControlTask.cpp, MotionParameterJournal.hpp, MotionParameterStorage.cpp, MotionPersistence.cpp, MotionStorageInterlock.hpp]
2026-09-14 feat(firmware): add configurable motor deadzone
    Add the deadzone command for remotely tuning both wheel PWM outputs.
    Persist the shared value with backward-compatible Flash storage.
    Set the default motor deadzone to zero and update tests and docs.
2026-09-16 Add servo installation mode and optimize MPU6050
    - Add install on/off/status commands with minimum leg-height locking.
    - Disable motor output and adaptive leg-height control during installation.
    - Fix servo PWM restart behavior and improve safety handling.
    - Optimize MPU6050 sampling, filtering, scaling, and bias estimation.
    - Add firmware tests and validation documentation.
    [BoardHardware.cpp, BoardHardware.hpp, CommandServiceTask.cpp, ControlState.cpp, ControlState.hpp, MPU6050.cpp, MPU6050.h, MotionControlTask.cpp]
2026-09-19 fix: restore IMU timing and retain fusion across control toggles
    Address IMU feedback changes introduced by ba5b8e7 that may contribute to
    balance overshoot and oscillation after enabling control.
    - Restore DLPF=0 and SMPLRT_DIV=9 for 800 Hz sensor register updates
    - Keep host sampling and VQF integration at 100 Hz with a 10 ms period
    - Continue attitude fusion and gyro bias estimation during ordinary control off
    - Preserve learned fusion state on control on while retaining the 500 ms
    startup gate
    - Keep installation, maintenance, and fault handling paths intact
    - Preserve corrected sensor scaling, coherent reads, and configuration checks
    - Add regression coverage for sensor timing and es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
    [BoardHardware.hpp, ControlState.hpp, MPU6050.cpp, MPU6050.h, MotionControlTask.cpp, MotionParameterJournal.hpp, check_firmware_images.py]
2026-09-23 feat: add UID and persistent auto-leg commands
    - Add a `uid` command that returns the STM32's 96-bit unique ID.
    - Add `autoleg on|off|status`, matching the feature/launch command interface.
    The switch defaults to enabled, persists through Flash, and reads v1-v3
    records with auto-leg enabled by default. Keep the journal record size
    unchanged with schema v4.
2026-09-25 Add persistent roll midpoint calibration
    - Add the `rollbias` command and apply calibration to roll control and safety gates
    - Persist the offset in v5 Flash records with legacy compatibility
    - Fix formatting of negative fractional angles
    - Cover calibration and persistence in host tests
    [BalanceStartupGate.hpp, CommandServiceTask.cpp, ControlState.hpp, MotionControlTask.cpp, MotionParameterCommands.hpp, MotionParameterJournal.hpp, MotionParameters.hpp]
2026-09-29 Remove unnecessary files
    [STlink.cfg]
2026-10-03 add BOM
    [BOM.xlsx]
